chavarriajose/Eurorack-MIDI/hardware/schematics/full-circuit.png

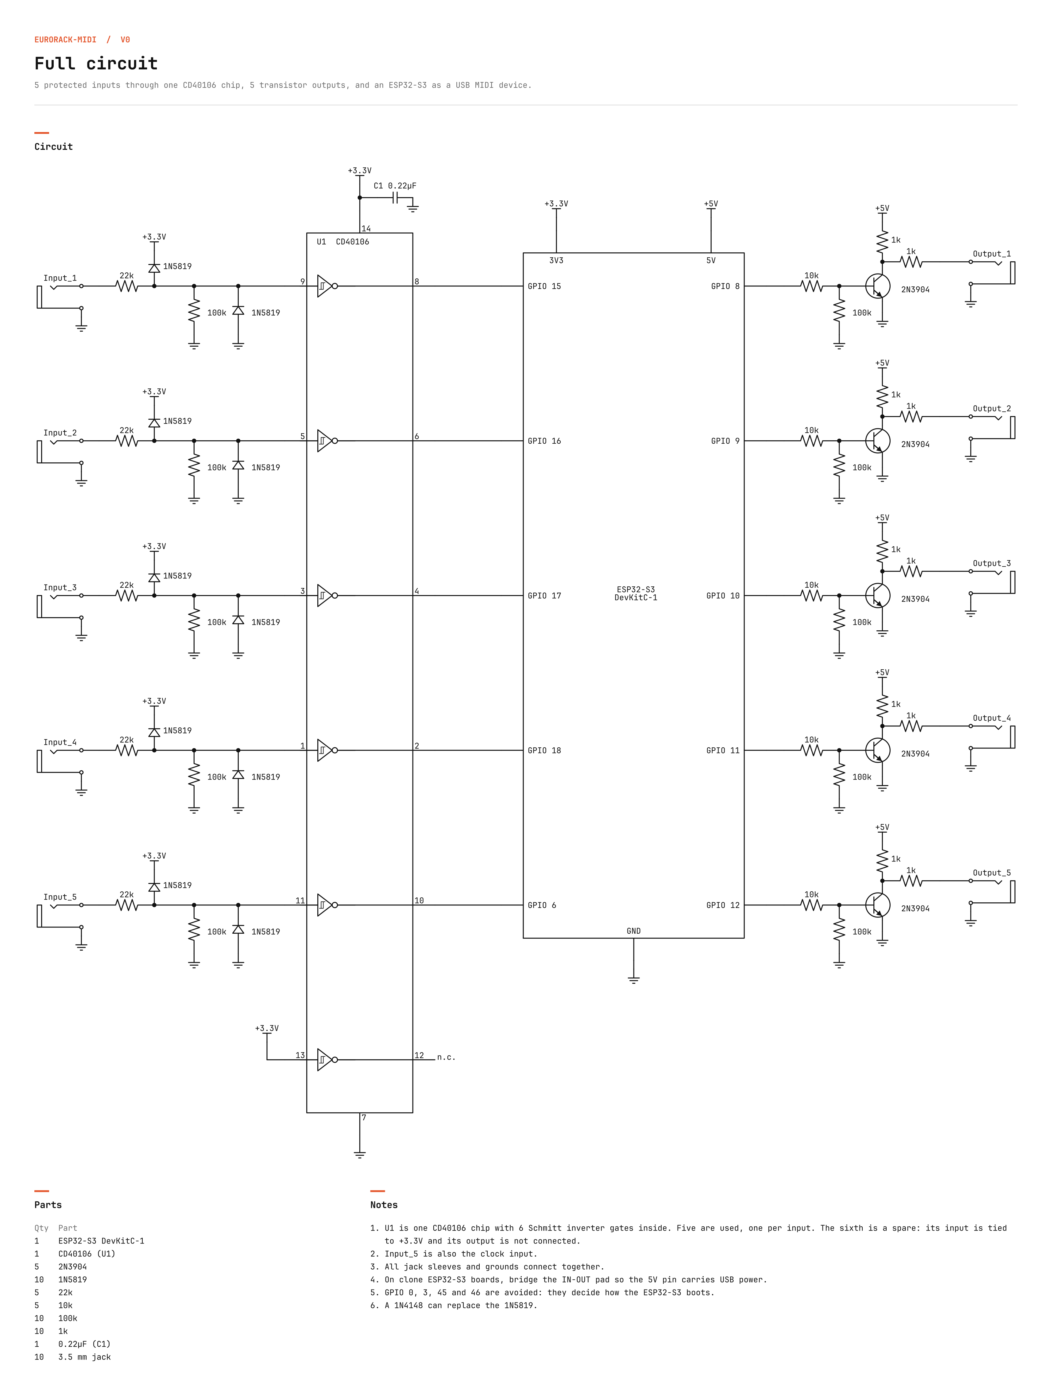
hardware/schematics/full-circuit.png
