chavarriajose/Eurorack-MIDI/hardware/schematics/input-channel.png

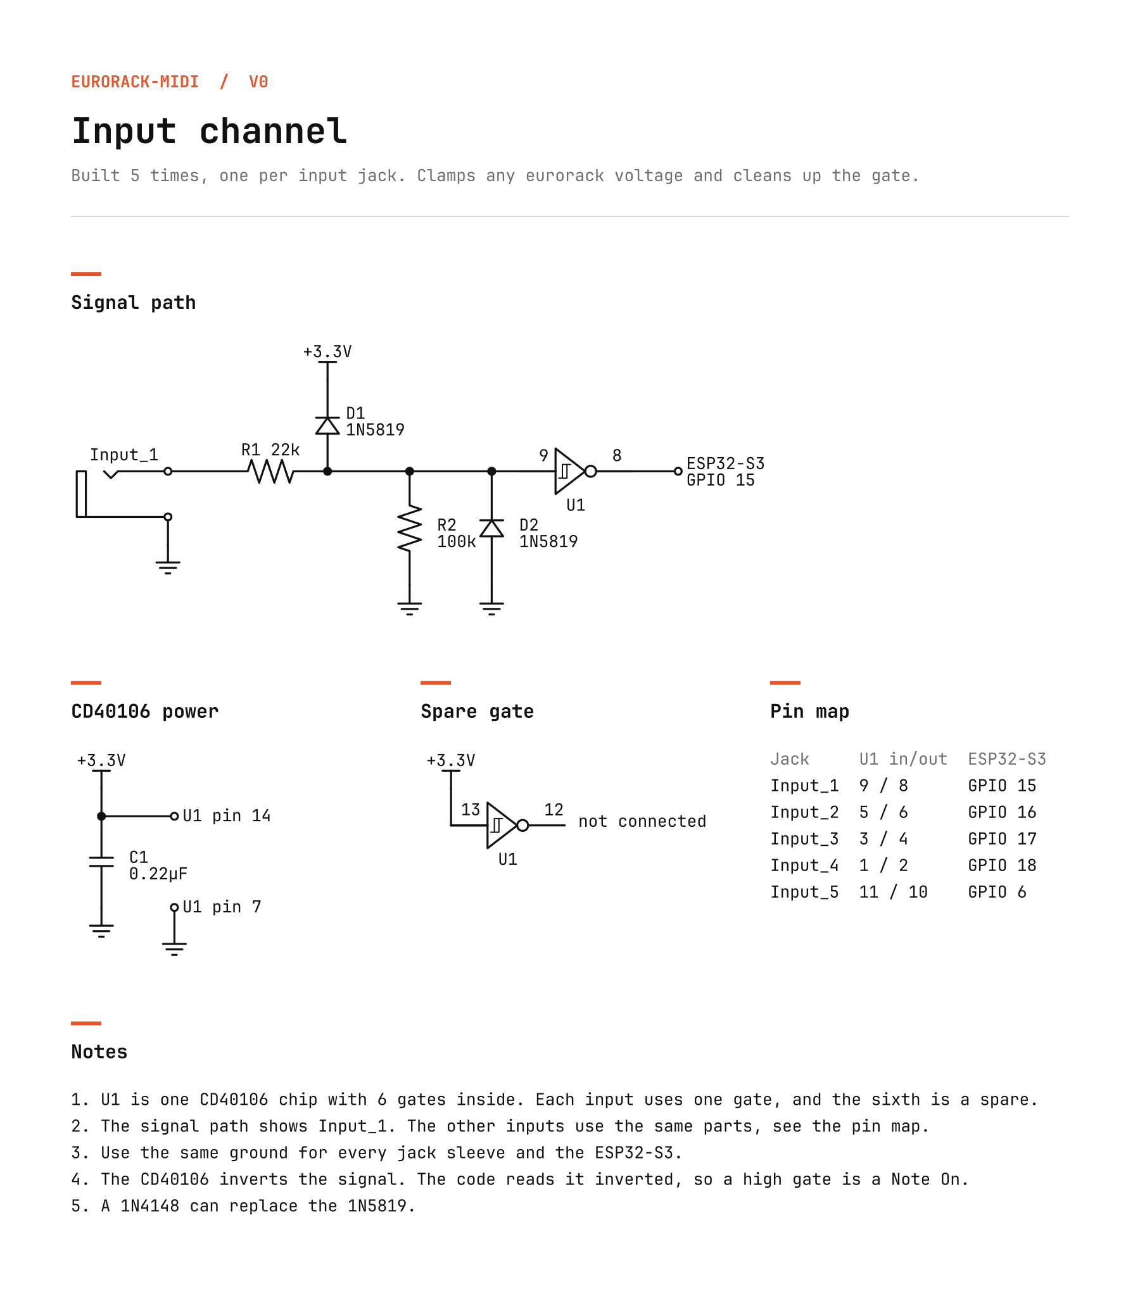
hardware/schematics/input-channel.png
