chavarriajose/Eurorack-MIDI/hardware/schematics/output-channel.png

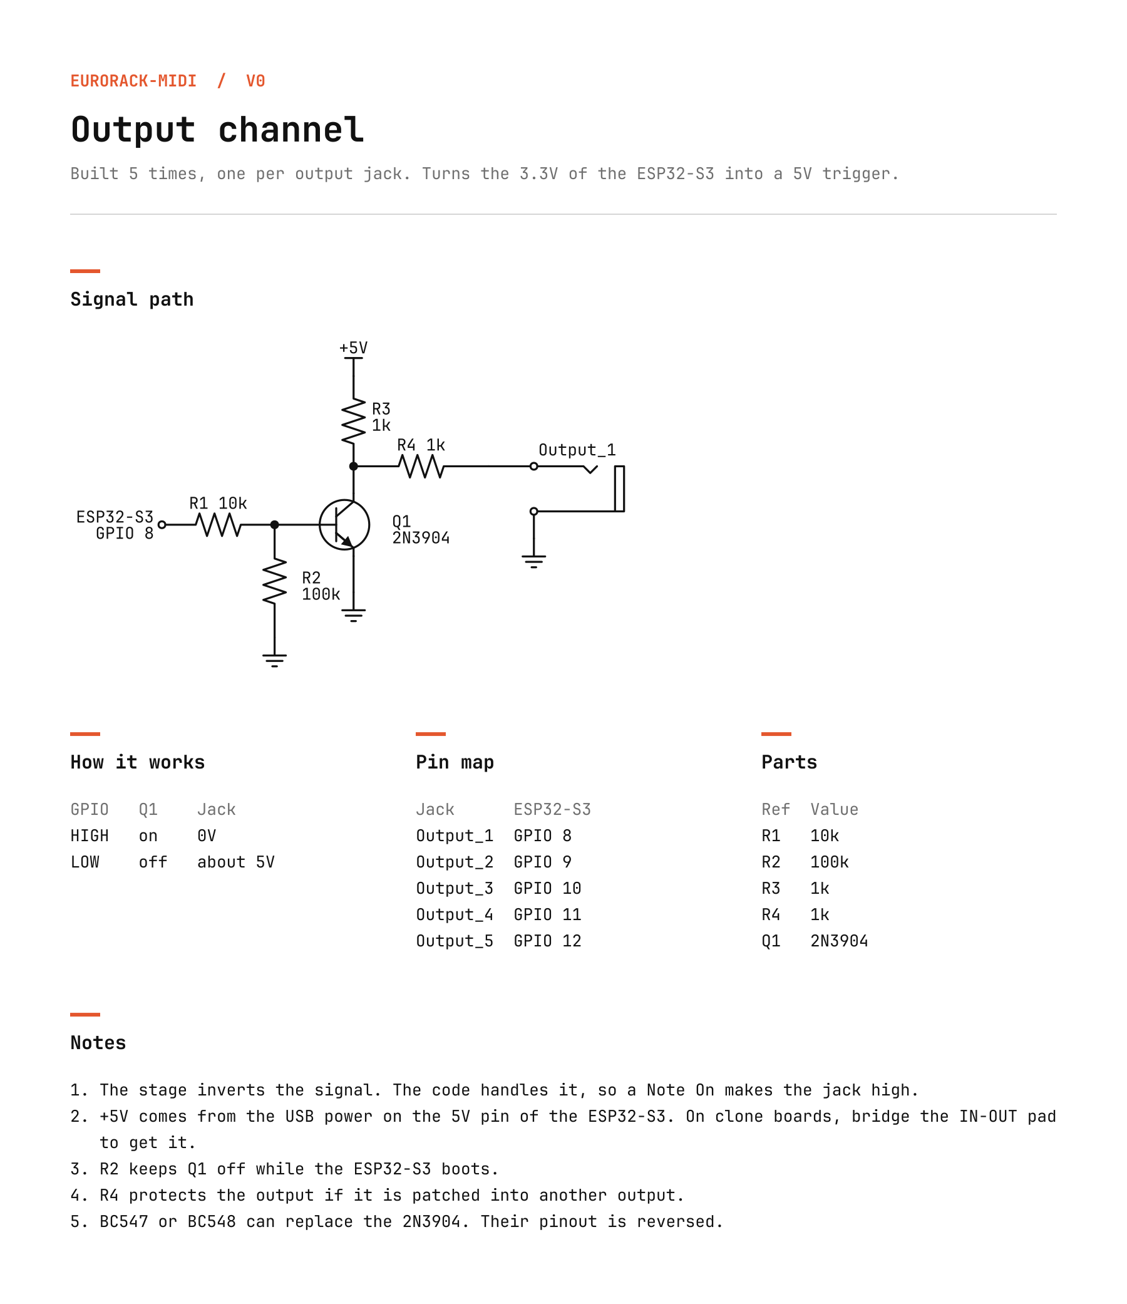
hardware/schematics/output-channel.png
